phongulus/light-messenger/images/IMG_1188.JPG

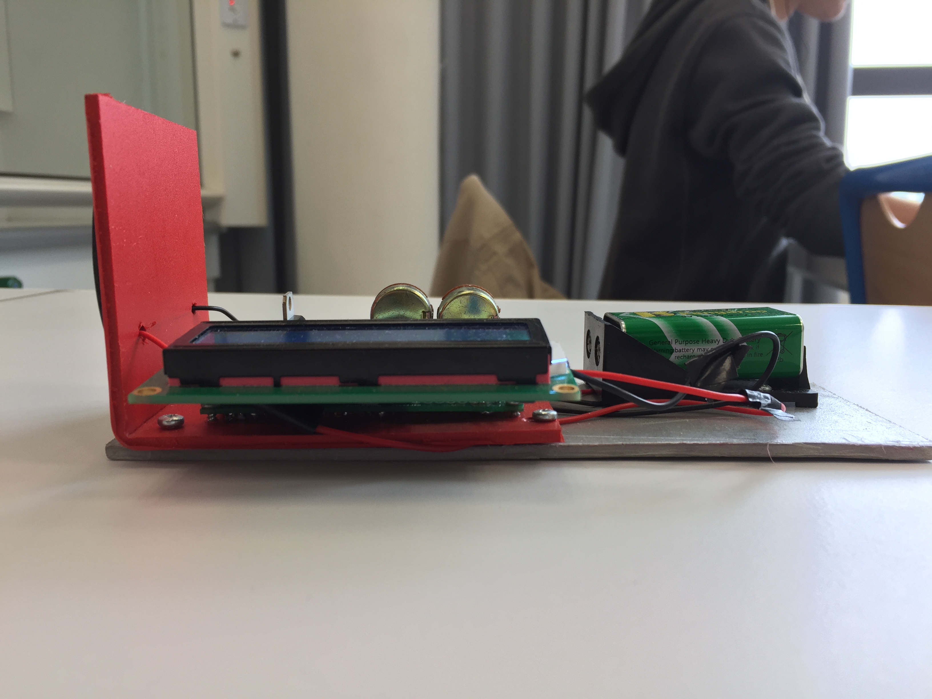
images/IMG_1188.JPG
