phongulus/light-messenger/images/IMG_1197.JPG

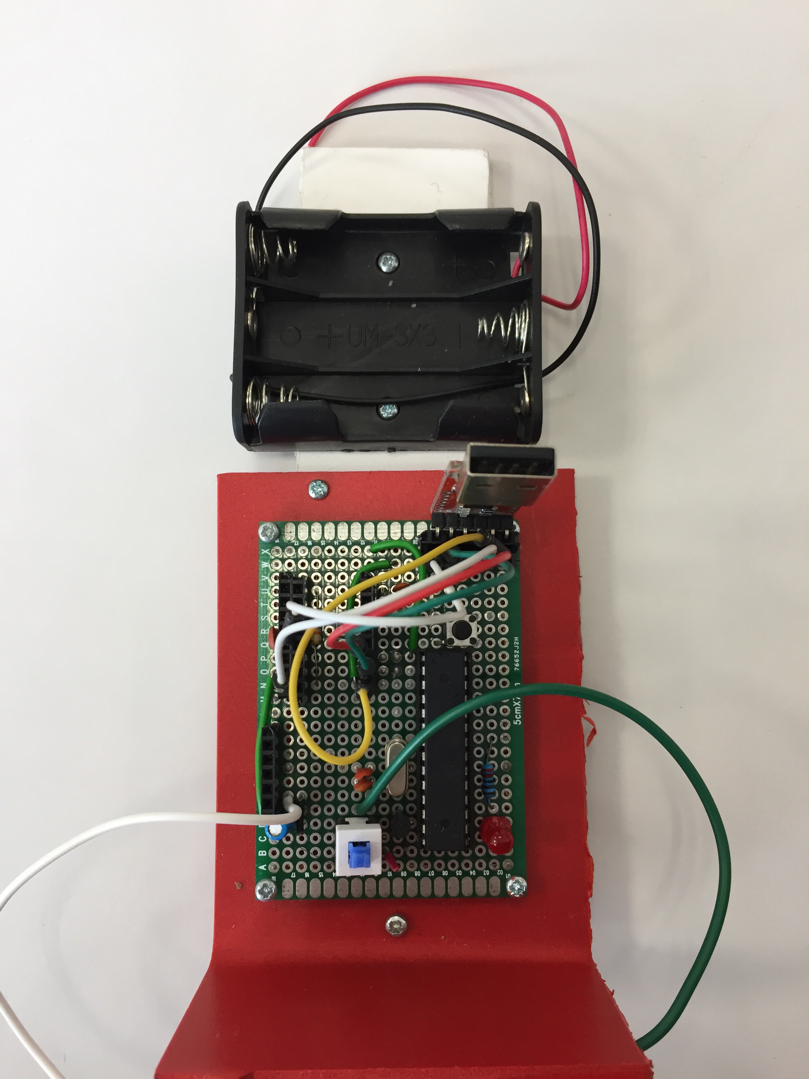
images/IMG_1197.JPG
