phongulus/light-messenger/images/IMG_1189.JPG

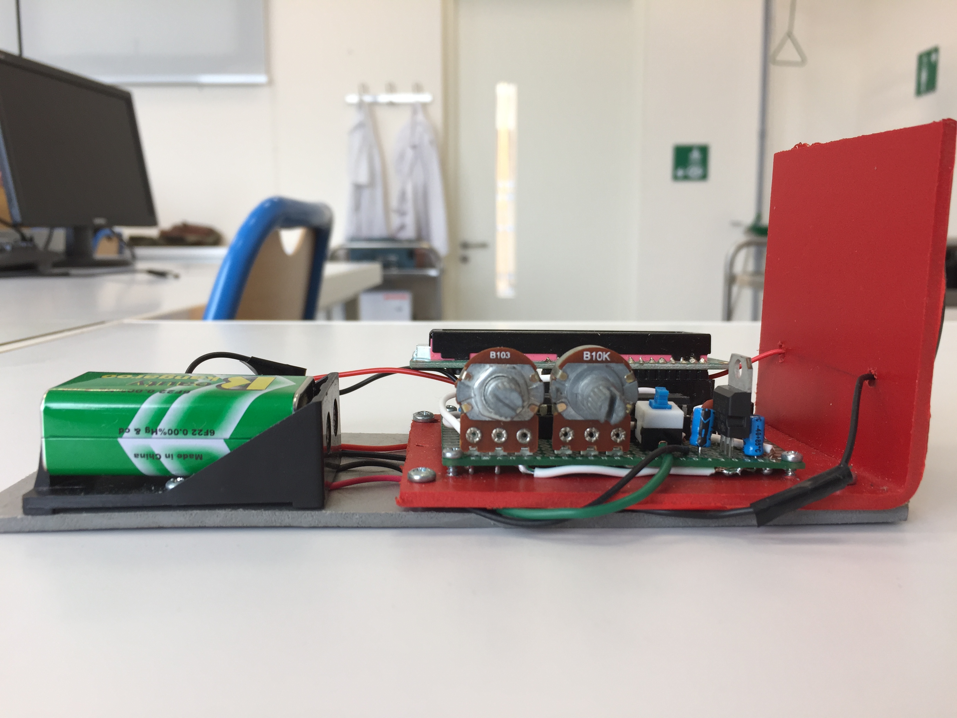
images/IMG_1189.JPG
