phongulus/light-messenger/images/IMG_1190.JPG

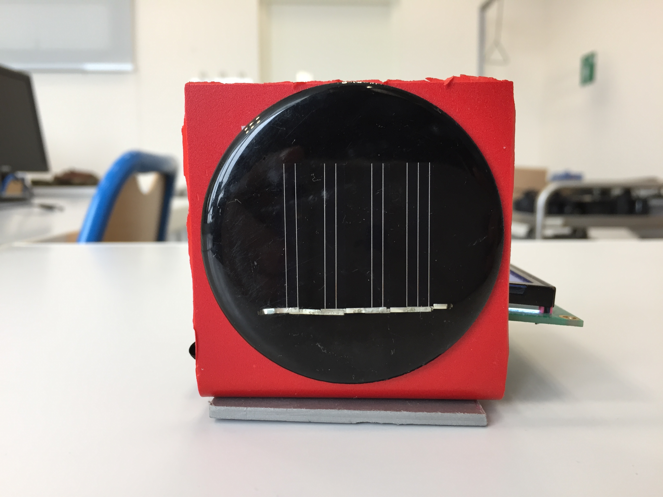
images/IMG_1190.JPG
