phongulus/light-messenger/images/IMG_1191.JPG

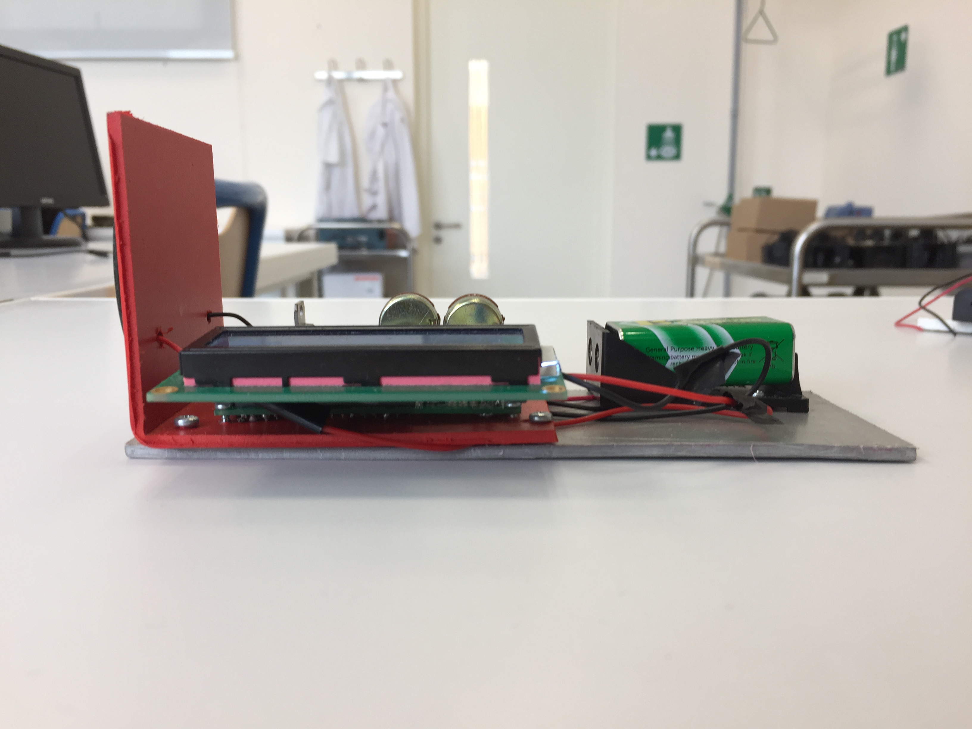
images/IMG_1191.JPG
