phongulus/light-messenger/images/IMG_1192.JPG

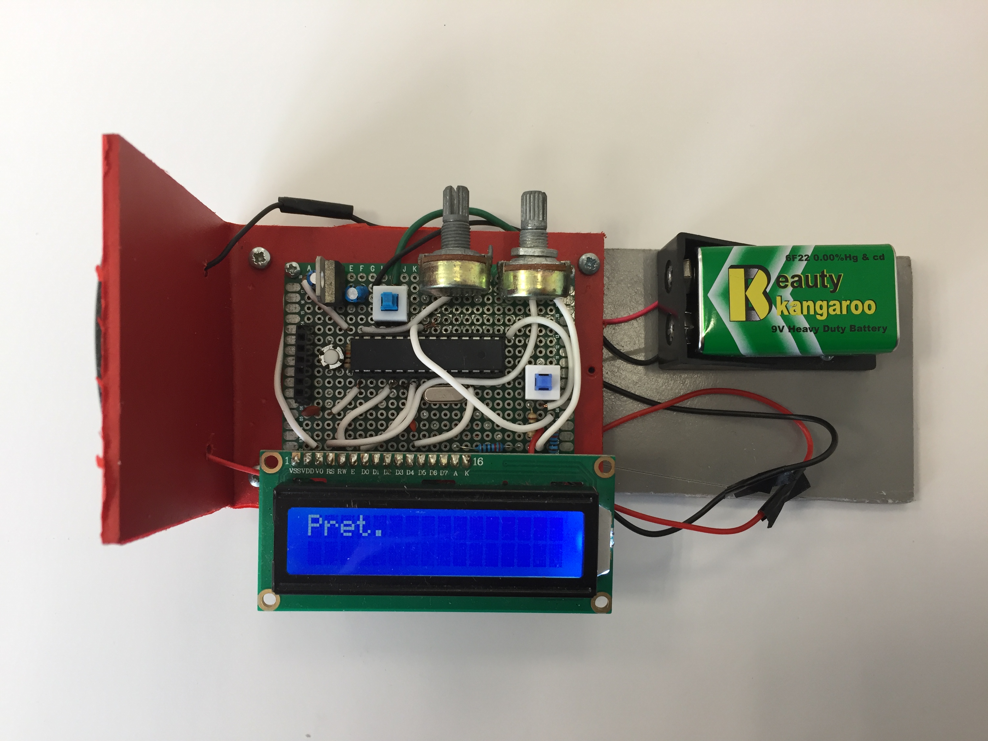
images/IMG_1192.JPG
