phongulus/light-messenger/images/IMG_1193.JPG

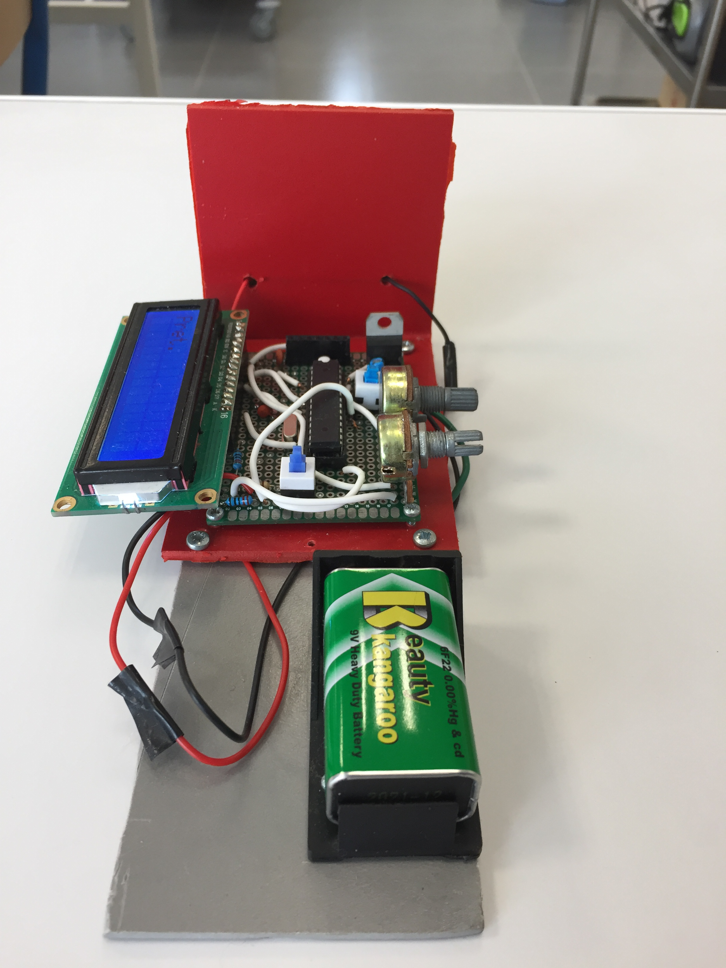
images/IMG_1193.JPG
