phongulus/light-messenger/images/IMG_1194.JPG

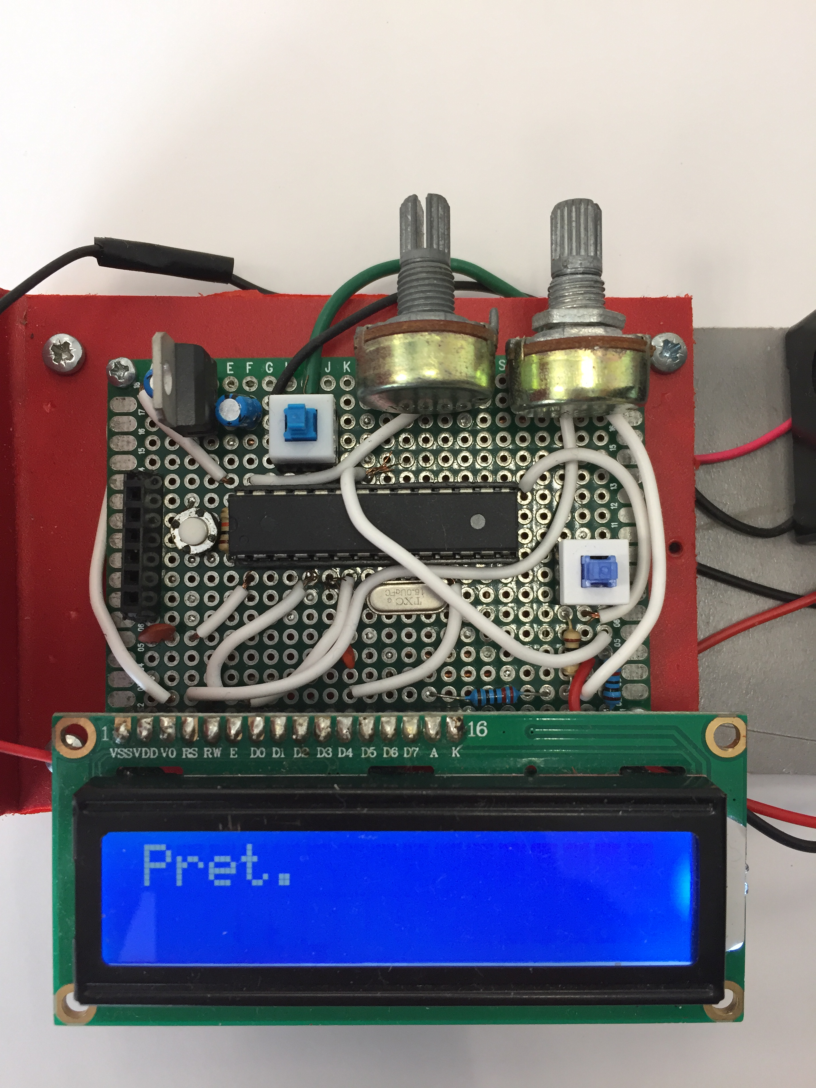
images/IMG_1194.JPG
