phongulus/light-messenger/images/IMG_1195.JPG

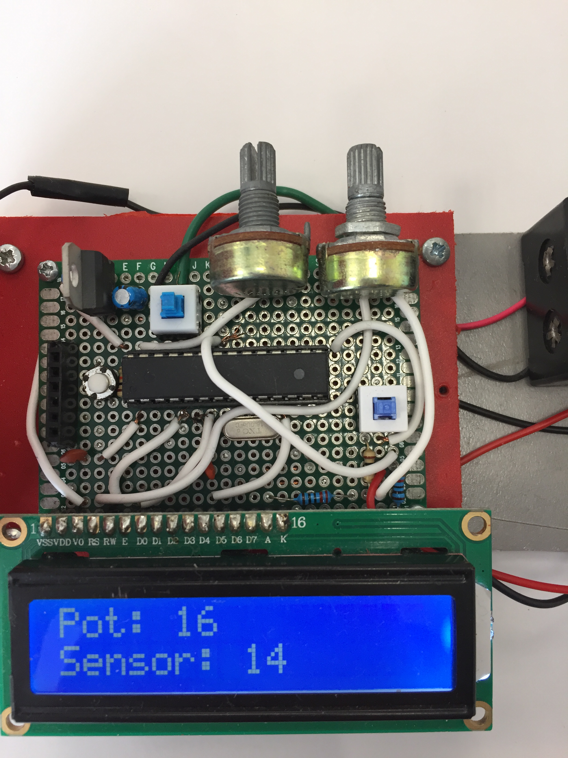
images/IMG_1195.JPG
