phongulus/light-messenger/images/IMG_1196.JPG

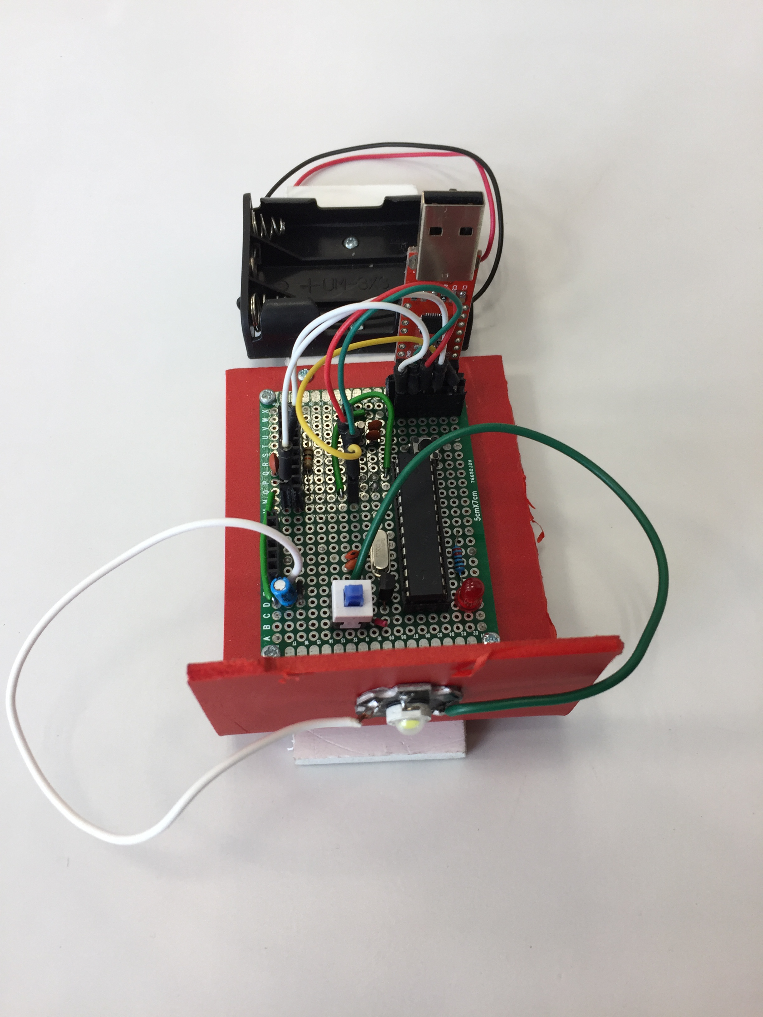
images/IMG_1196.JPG
