phongulus/light-messenger/images/IMG_1198.JPG

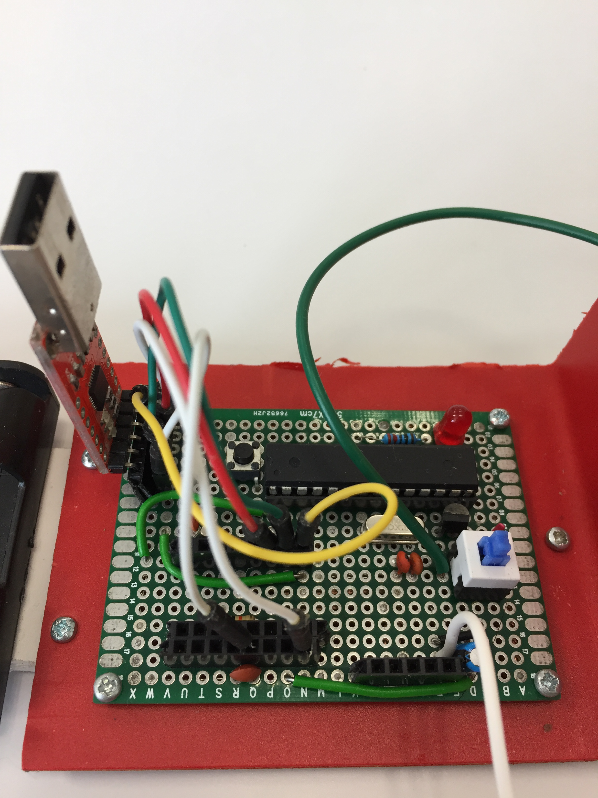
images/IMG_1198.JPG
