phongulus/light-messenger/images/IMG_1199.JPG

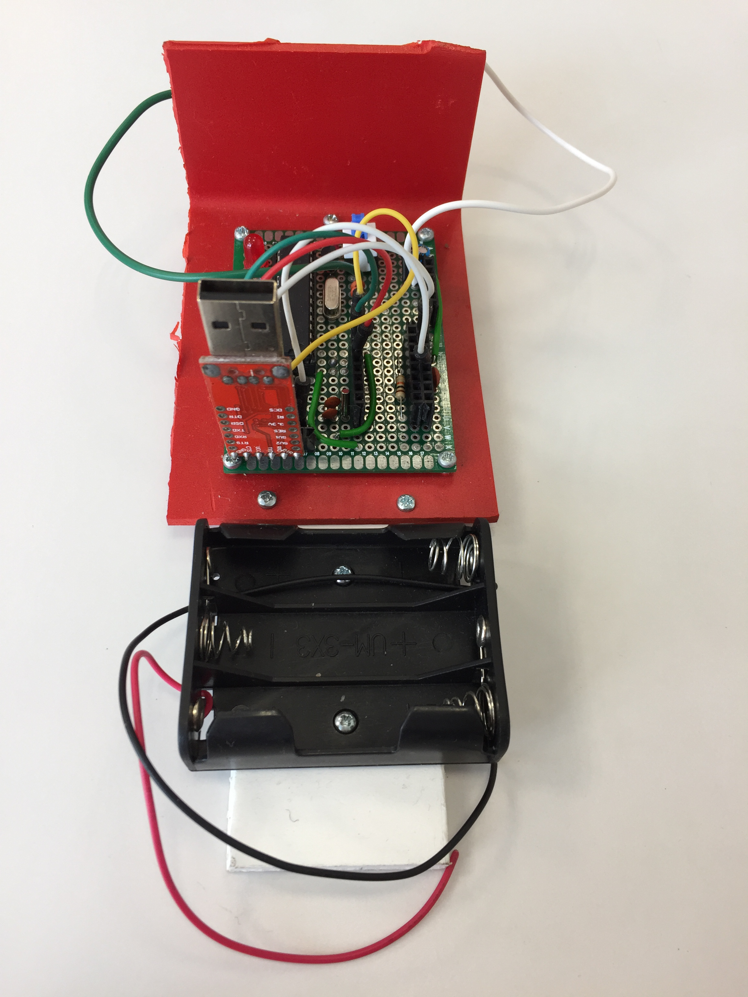
images/IMG_1199.JPG
