phongulus/light-messenger/images/IMG_1200.JPG

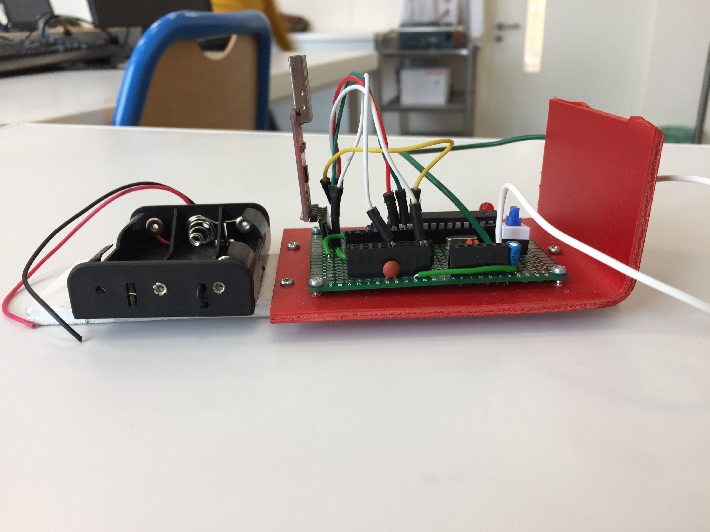
images/IMG_1200.JPG
