phongulus/light-messenger/images/IMG_1201.JPG

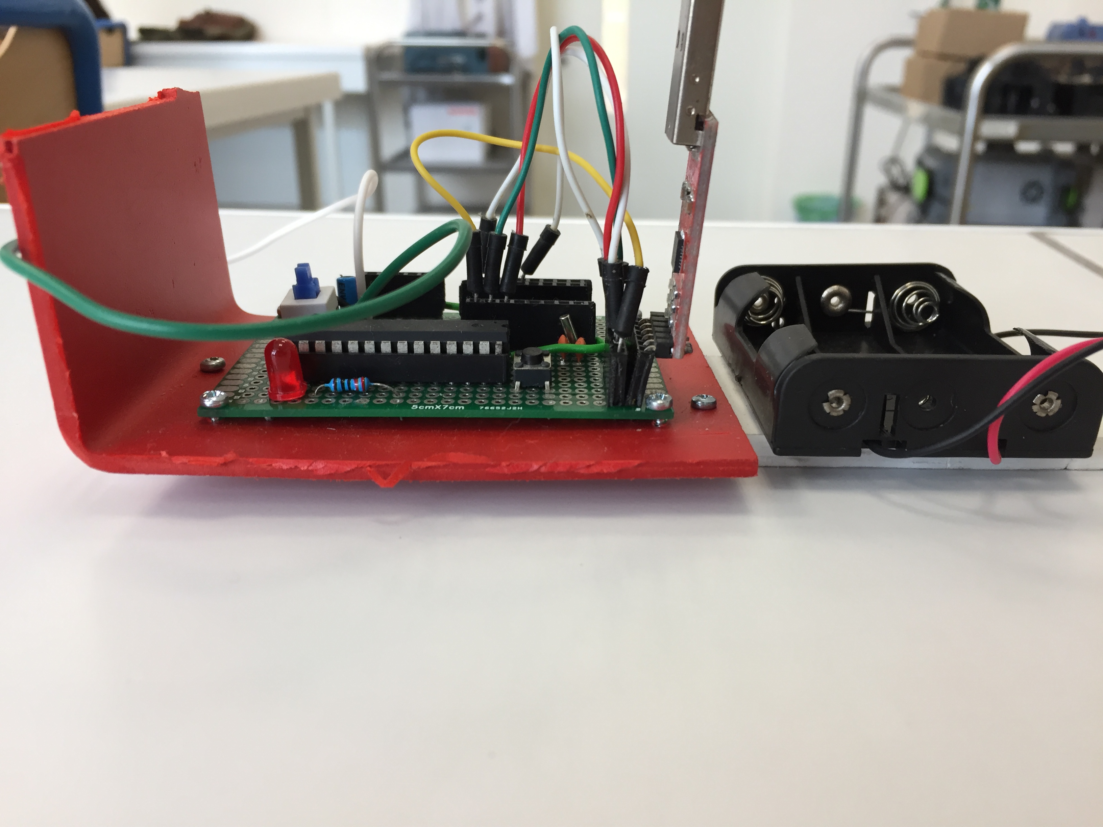
images/IMG_1201.JPG
