phongulus/light-messenger/images/IMG_1202.JPG

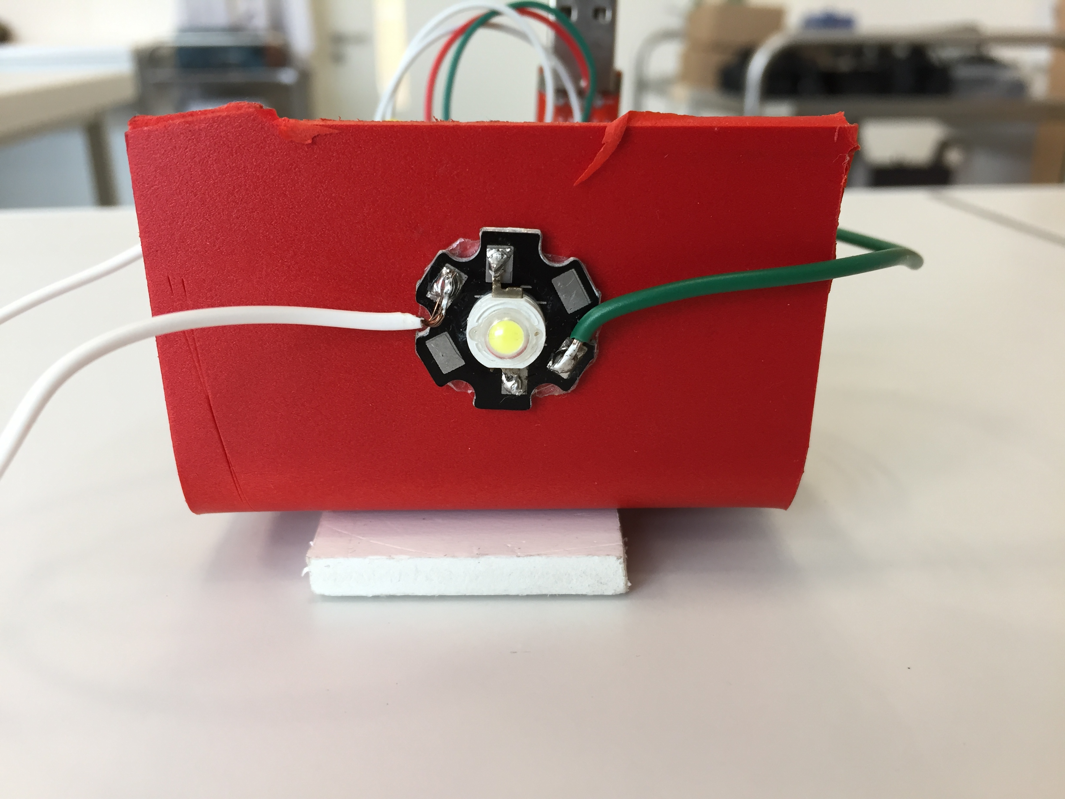
images/IMG_1202.JPG
